Lilendra-Pasindu-Harsha/GasGuard/assets/gasguard-qr.jpeg

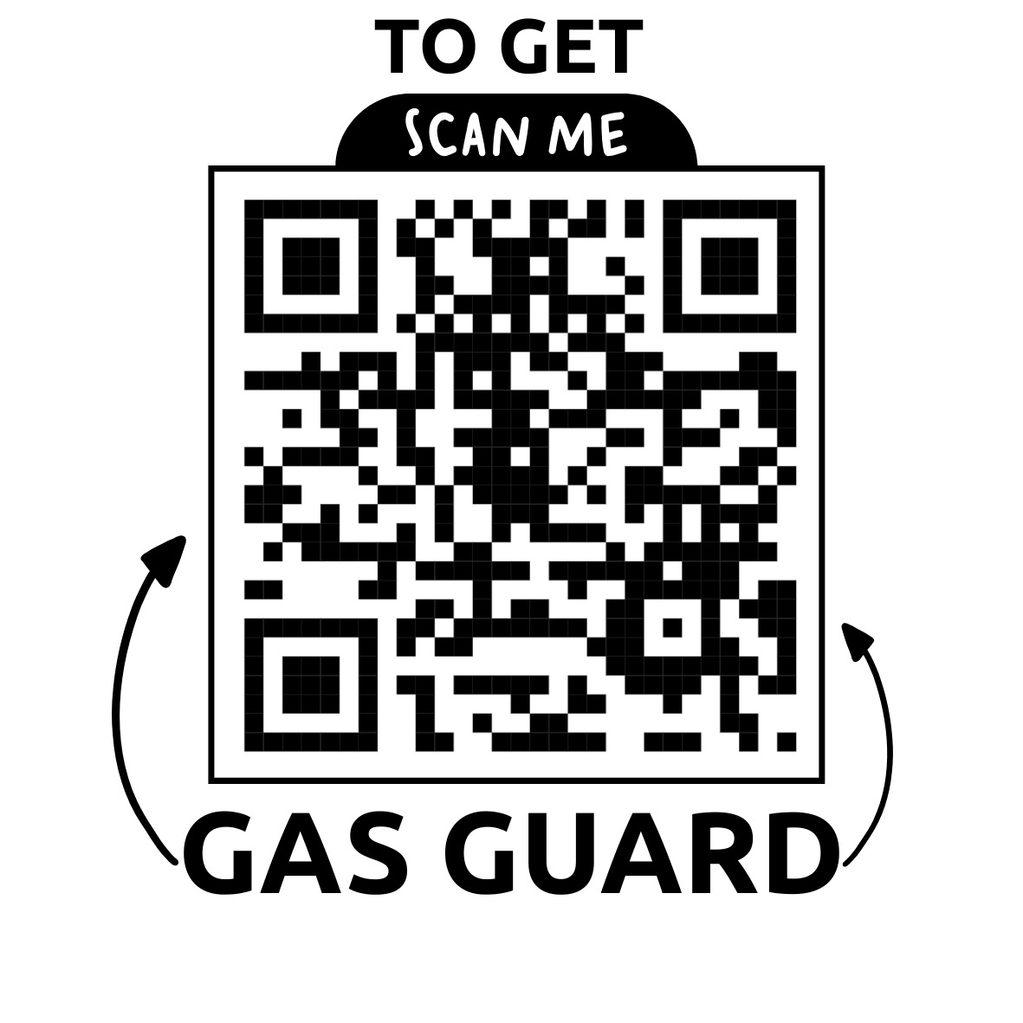
assets/gasguard-qr.jpeg
