Lilendra-Pasindu-Harsha/GasGuard/GasGuard_ML/gasguard_models/gasguard_ml_analysis.png

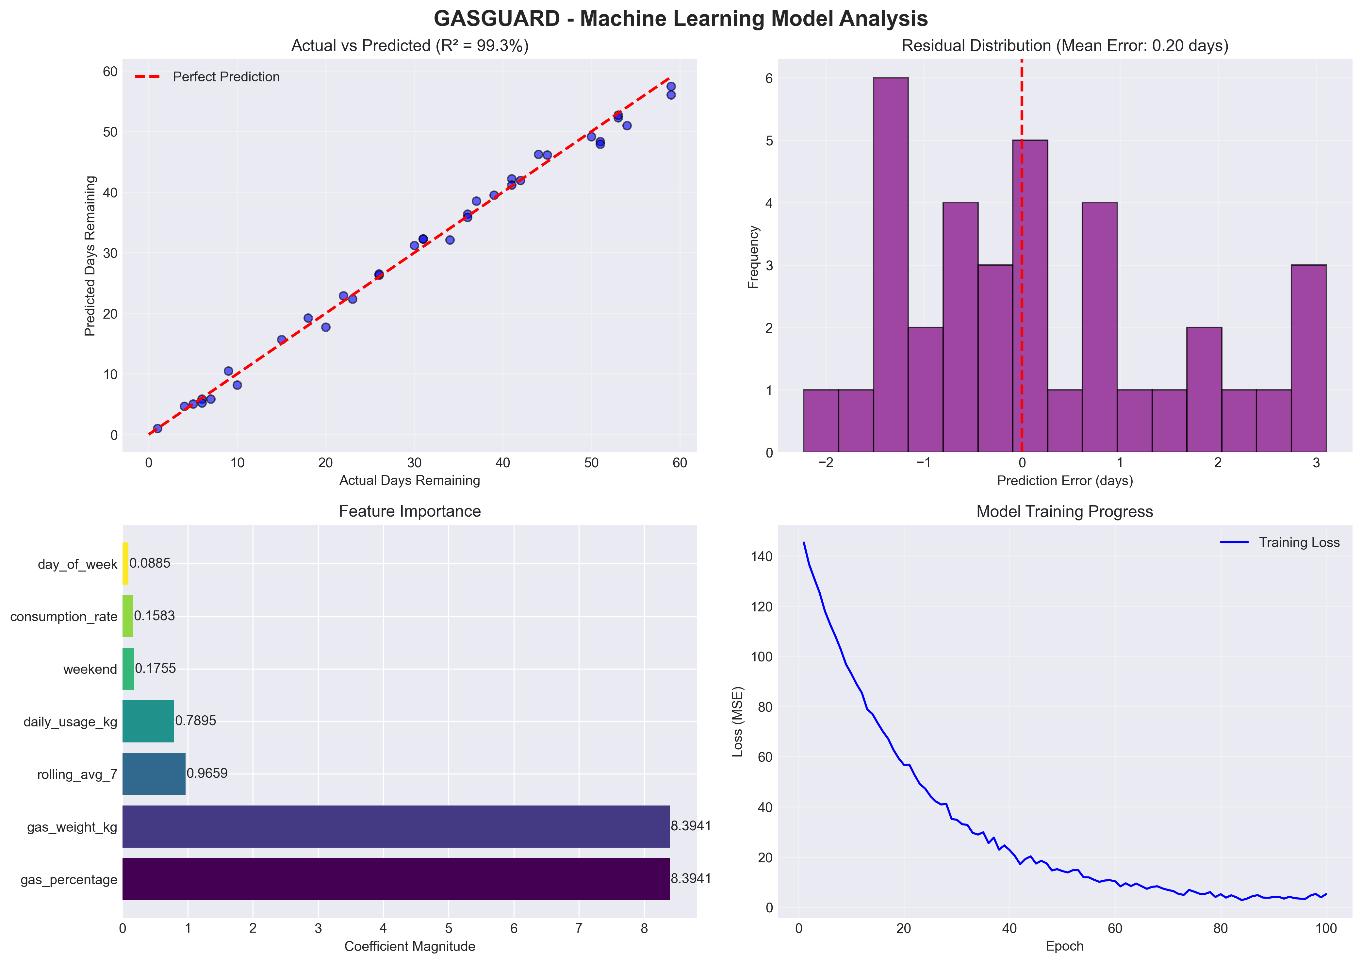
GasGuard_ML/gasguard_models/gasguard_ml_analysis.png
