Lilendra-Pasindu-Harsha/GasGuard/GasGuard_ML/gasguard_plots/actual_vs_predicted.png

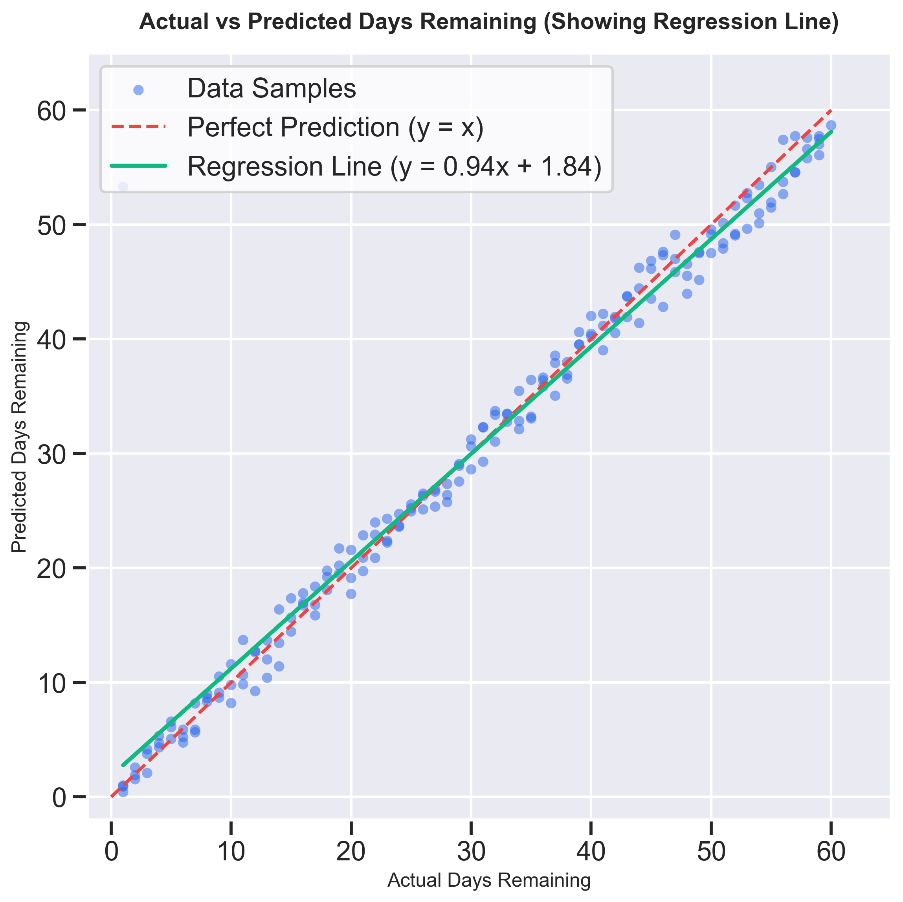
GasGuard_ML/gasguard_plots/actual_vs_predicted.png
