Lilendra-Pasindu-Harsha/GasGuard/GasGuard_ML/gasguard_plots/feature_correlation_heatmap.png

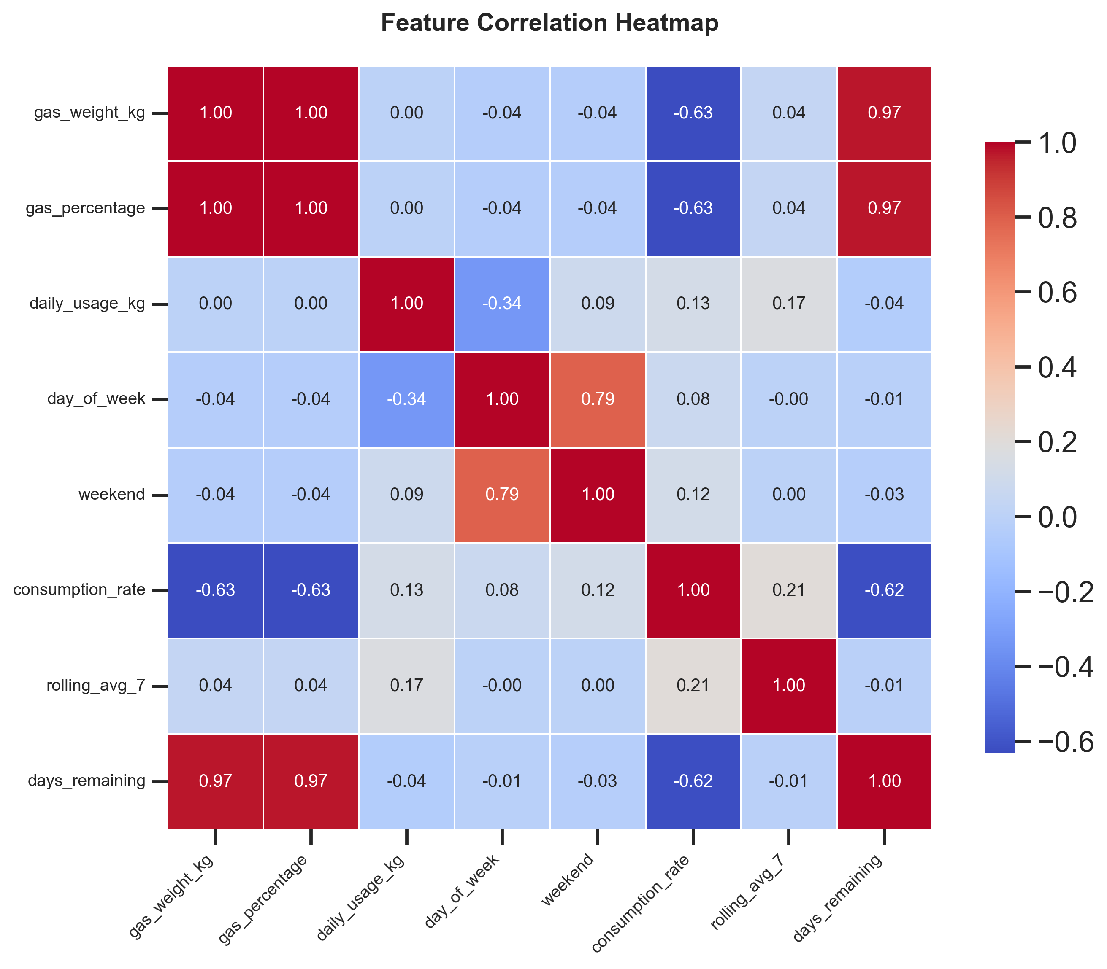
GasGuard_ML/gasguard_plots/feature_correlation_heatmap.png
