Lilendra-Pasindu-Harsha/GasGuard/GasGuard_ML/gasguard_plots/feature_importance.png

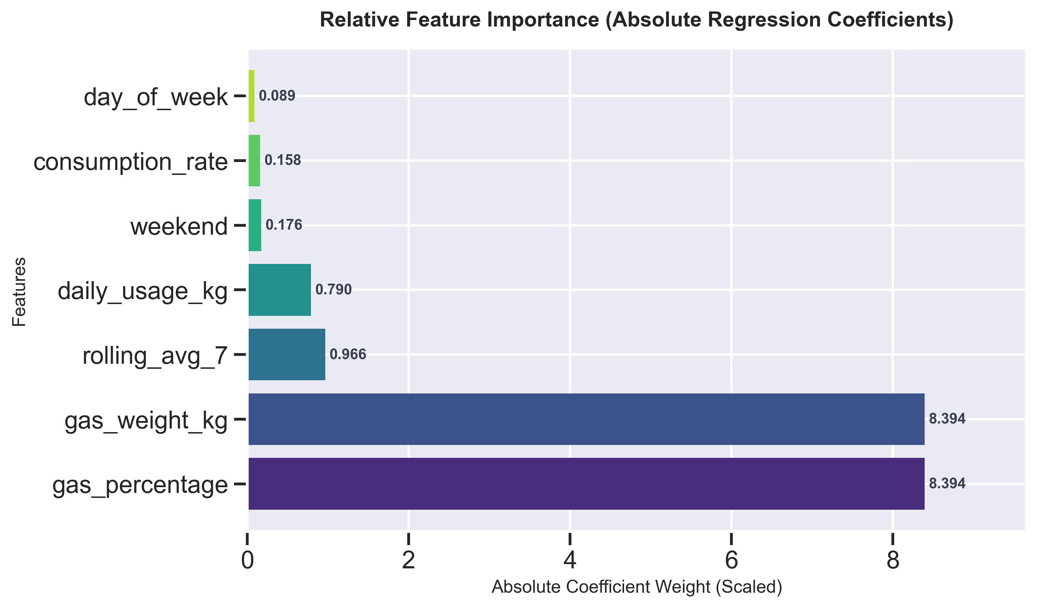
GasGuard_ML/gasguard_plots/feature_importance.png
