Lilendra-Pasindu-Harsha/GasGuard/GasGuard_ML/gasguard_plots/gas_depletion_cycles.png

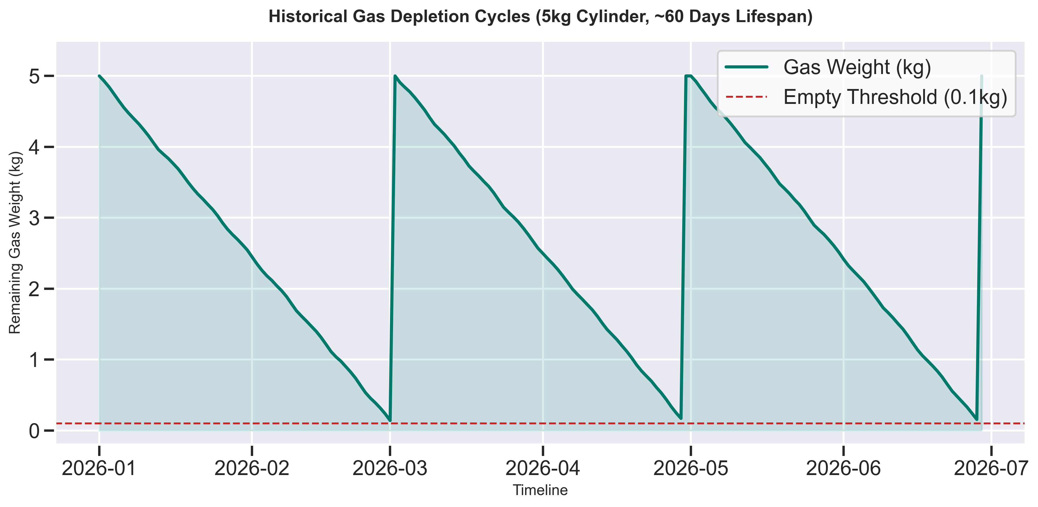
GasGuard_ML/gasguard_plots/gas_depletion_cycles.png
