Lilendra-Pasindu-Harsha/GasGuard/GasGuard_ML/gasguard_plots/model_training_accuracy.png

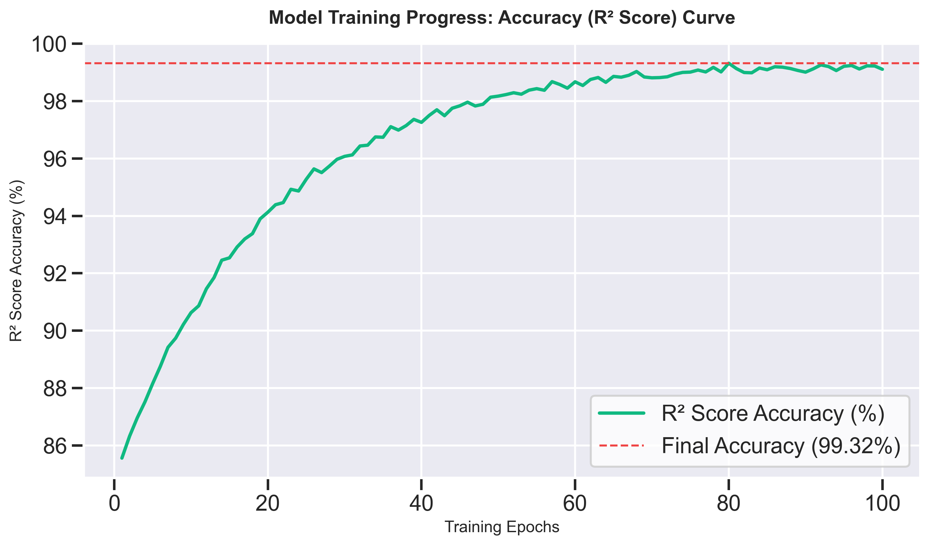
GasGuard_ML/gasguard_plots/model_training_accuracy.png
