Lilendra-Pasindu-Harsha/GasGuard/GasGuard_ML/gasguard_plots/model_training_loss.png

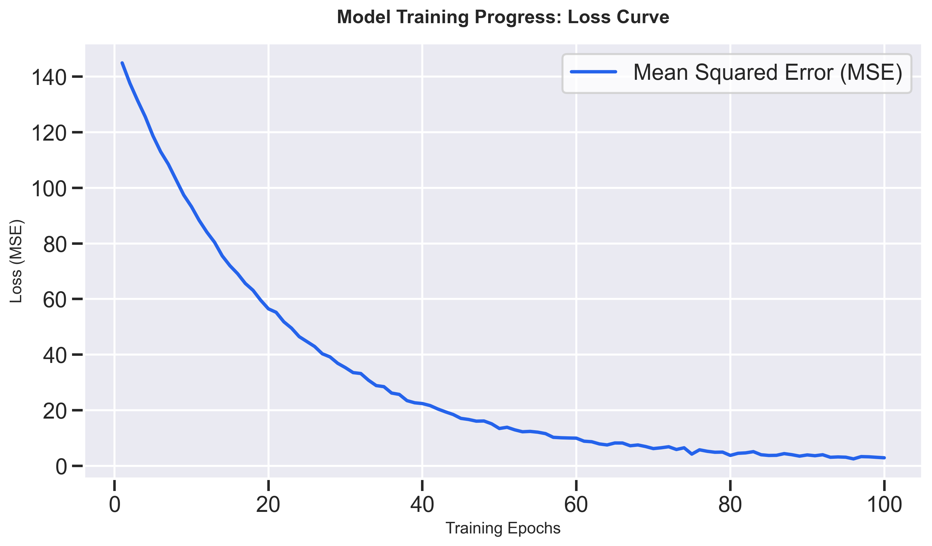
GasGuard_ML/gasguard_plots/model_training_loss.png
