Lilendra-Pasindu-Harsha/GasGuard/GasGuard_ML/gasguard_plots/residual_distribution.png

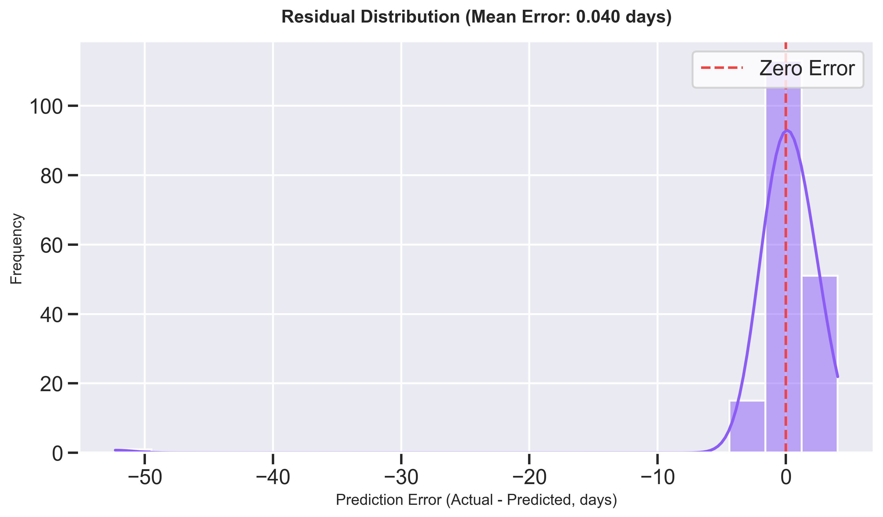
GasGuard_ML/gasguard_plots/residual_distribution.png
