Lilendra-Pasindu-Harsha/GasGuard/GasGuard_ML/gasguard_plots/weekly_consumption_pattern.png

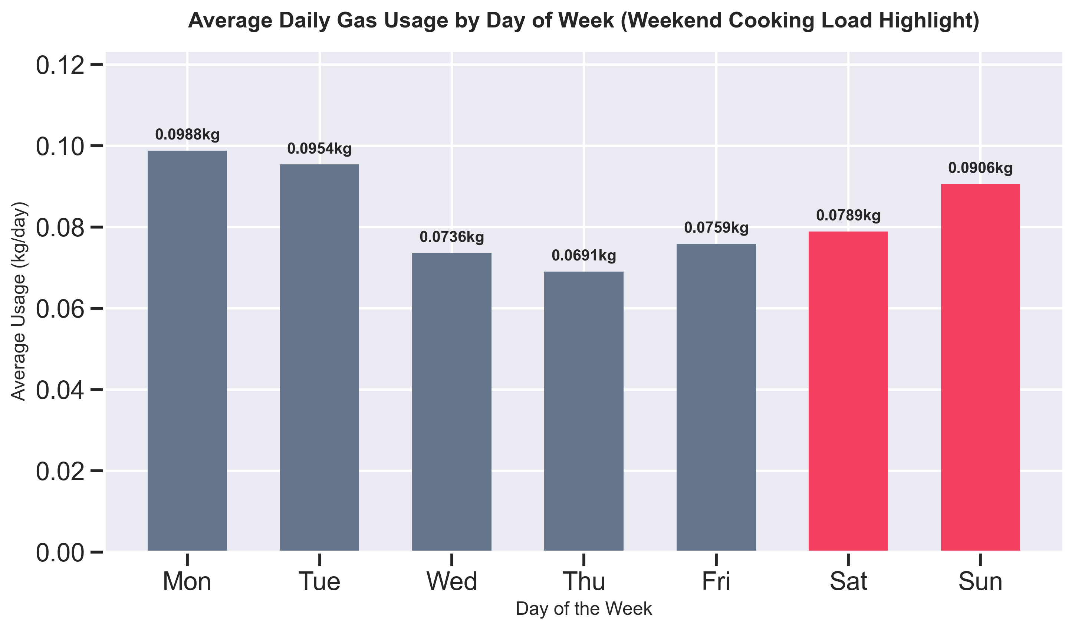
GasGuard_ML/gasguard_plots/weekly_consumption_pattern.png
