Lilendra-Pasindu-Harsha/GasGuard/GasGuard_PCB Image.jpeg

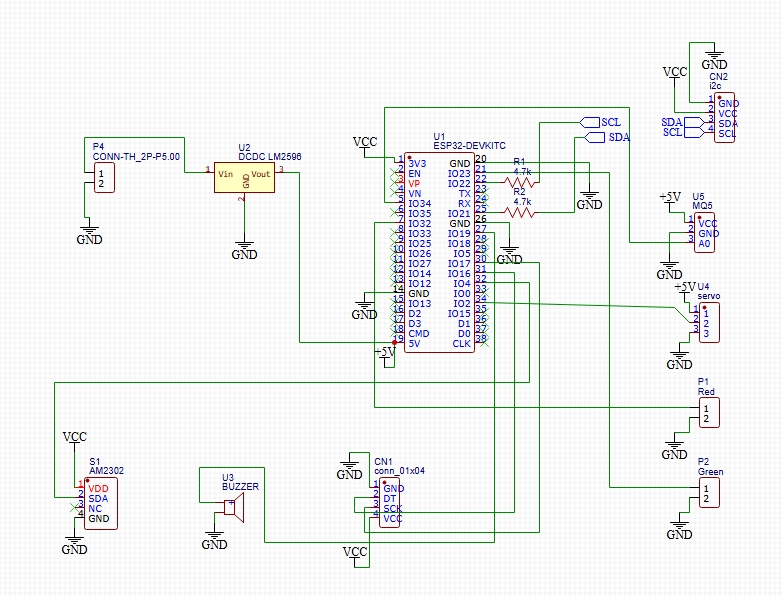
GasGuard_PCB Image.jpeg
