Lilendra-Pasindu-Harsha/GasGuard/GasGuard_ML/how to run ML.PNG

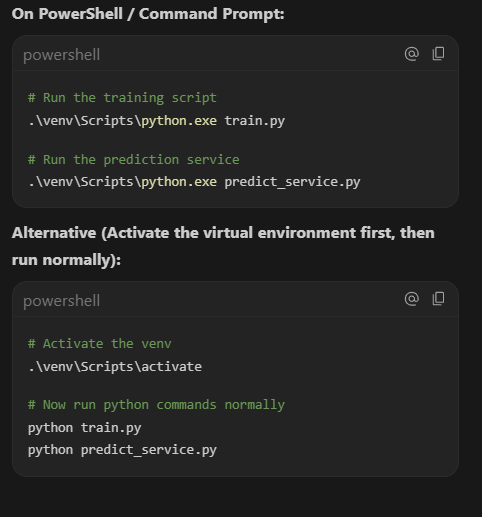
GasGuard_ML/how to run ML.PNG
