Lilendra-Pasindu-Harsha/GasGuard/GasGuard_Diagnostics_Tools/gasguard_test_console.html

# 🔥 GasGuard ML Test Console

Push simulated sensor data to Firebase → Watch your mobile app update in real-time

Disconnected

Gas Cylinder Weight

5.000

100.0%

−− −

Step: 0.01 kg

+ ++

Full (5.0 kg) 4.0 kg 3.0 kg 2.0 kg 1.0 kg Low (0.5 kg) Critical (0.1 kg) Empty (0.0 kg)

ML Predicted Days Left

Daily Usage

0.12 kg

Est. Monthly Cost

Rs. --

Pushes Sent

0
